sitruklaq/Mini-Pneumatics/README.md

# Mini-Pneumatics

A repository for the mini-pneumatic system for soft robotics.



The device has positive, negative, and exhaust inputs that control 1 output channel.

Pressure is monitored through a pressure sensor.
