sitruklaq/Mini-Pneumatics/Images/Layout.md

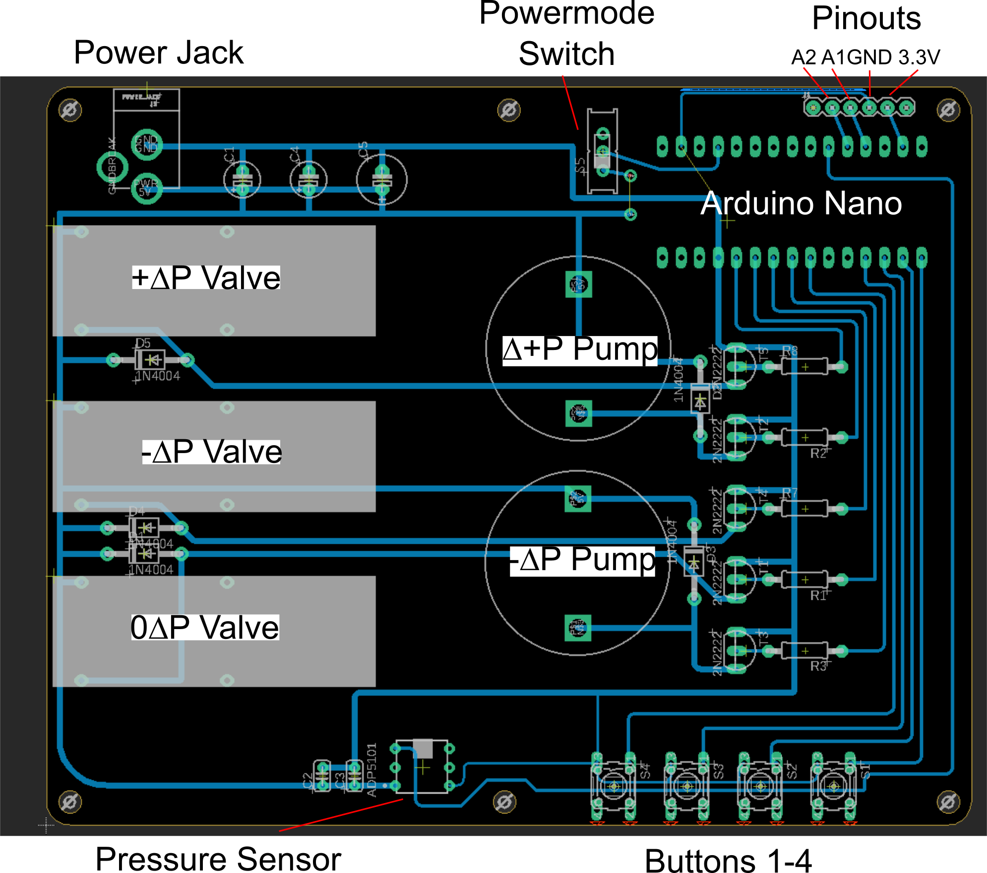
[picture p1: Images/layout.png]
layout


# Arduino Pin Assignments

| Item | Pin  | Valve/Pump Number |
| --- | ---- | --- |
| ∆+P Valve | 2 | 0 |
| -∆P Valve | 4 | 1 |
| 0∆P Valve | 5 | 2 |
| +∆P Pump | 3 | |
| -∆P Pump | 6 | |
| Button 1 | 9 | |
| Button 2 | 10 | |
| Button 3 | 11 | |
| Button 4 | 12 | |
| Pressure Sensor | A2 | |
