sitruklaq/Mini-Pneumatics/Components/BOM small pneumatics.xlsx

Small Pneumatics BOM
 |  | Description | Quantity | Pack Cost | Pack Amount | Unit Cost | Total Cost | Part Number` | Supplier | Purchase Link
 | Power Generation
 |  | Barrel Jack 2.1mm DC | 1 |  |  | $0.65 | $0.65 |  | creatroninc | https://www.creatroninc.com/product/1mm-dc-barrel-jack/?search_query=barrel+jack&results=22
 |  | Switch | 1
 | Electrical Control | Arduino Nano | 1 | $19.99 | 3 | $6.66 | $6.66 | Arduino 2560 | amazon.ca | https://www.amazon.ca/Elegoo-Board-ATmega2560-ATMEGA16U2-Arduino/dp/B01H4ZDYCE?s=hi
 | Pneumatics | Pneumatic Pumps Vacuum Pump 12V Mini Diaphragm Air Compressor with Silicone Tube | 2 | 6.99 | 1 | 6.99 | $13.98 |  | amazon.ca | https://www.amazon.ca/gp/product/B07C7341PP/ref=ppx_yo_dt_b_search_asin_title?ie=UTF8&psc=1
 |  | Pneumatic Valves | 3 |  |  | $6.95USD EA (min 25) | 76.45 |  | Jameco | https://www.jameco.com/z/RLB204KP30B-Asco-Valve-and-Instrument-2-Way-Barbed-Solenoid-Air-Valve-Normally-Closed_2258401.html
 |  | diode 1N4001 50V 1A rectifier Diode | 5 |  |  | 0.105 (0.42 per 4) | $1.16 | DIREC-004001 | creatroninc | https://www.creatroninc.com/product/1n4001-50v-1a-rectifier-diode-4-pack/?search_query=diode&results=75
 |  | transistor SS8050 - NPN BJT (25V 1.5A) | 5 |  |  | 0.6 | $6.60 | TRANQ-008050 | creatroninc | https://www.creatroninc.com/product/ss8050-npn-bjt-25v-15a/?search_query=transistor&results=146
 |  | resistor | 5 |  |  | ~0 | $0.00 |  | find a resistor pack around
 | sensor bank | pressure sensor Panasonic +-100kPa DIP mount | 1 |  |  | 60 | $60.00 | 769-ADP5101 | mouser.ca | https://www.mouser.ca/ProductDetail/Panasonic/ADP5101
 |  | capacitors
 | IO | Tactile Switches 0.05A 24VDC SPST Round Button | 4 |  |  | 0.68 | 2.72 | B3W-1020 | mouser.ca | https://www.mouser.com/ProductDetail/omron/b3w-1020/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
 | PCBS | dual or one sided PCB | 1 |  |  | 24 per 25 | $1.00 |  | bantamtools.com | https://www.bantamtools.com/miscellaneous/printed-circuit-board-blanks
 | Assorted | tubing
 |  | luer connectors
 |  | pin extenders
 |  | standoffs and screws 250Pcs M3 Male to Female Hex Column Standoff Spacer Pillars Screws Nuts Assortment Kit with Storage Box (M3) | 1 pack |  |  | 18.69 |  |  | amazon.ca | https://www.amazon.ca/250Pcs-Standoff-Pillars-Assortment-Storage/dp/B071RXSMW6?s=gateway
