sitruklaq/Mini-Pneumatics/PCB/mini system- 5 components.brd

## EAGLE design PCB/mini system- 5 components.brd (2020-03-27)

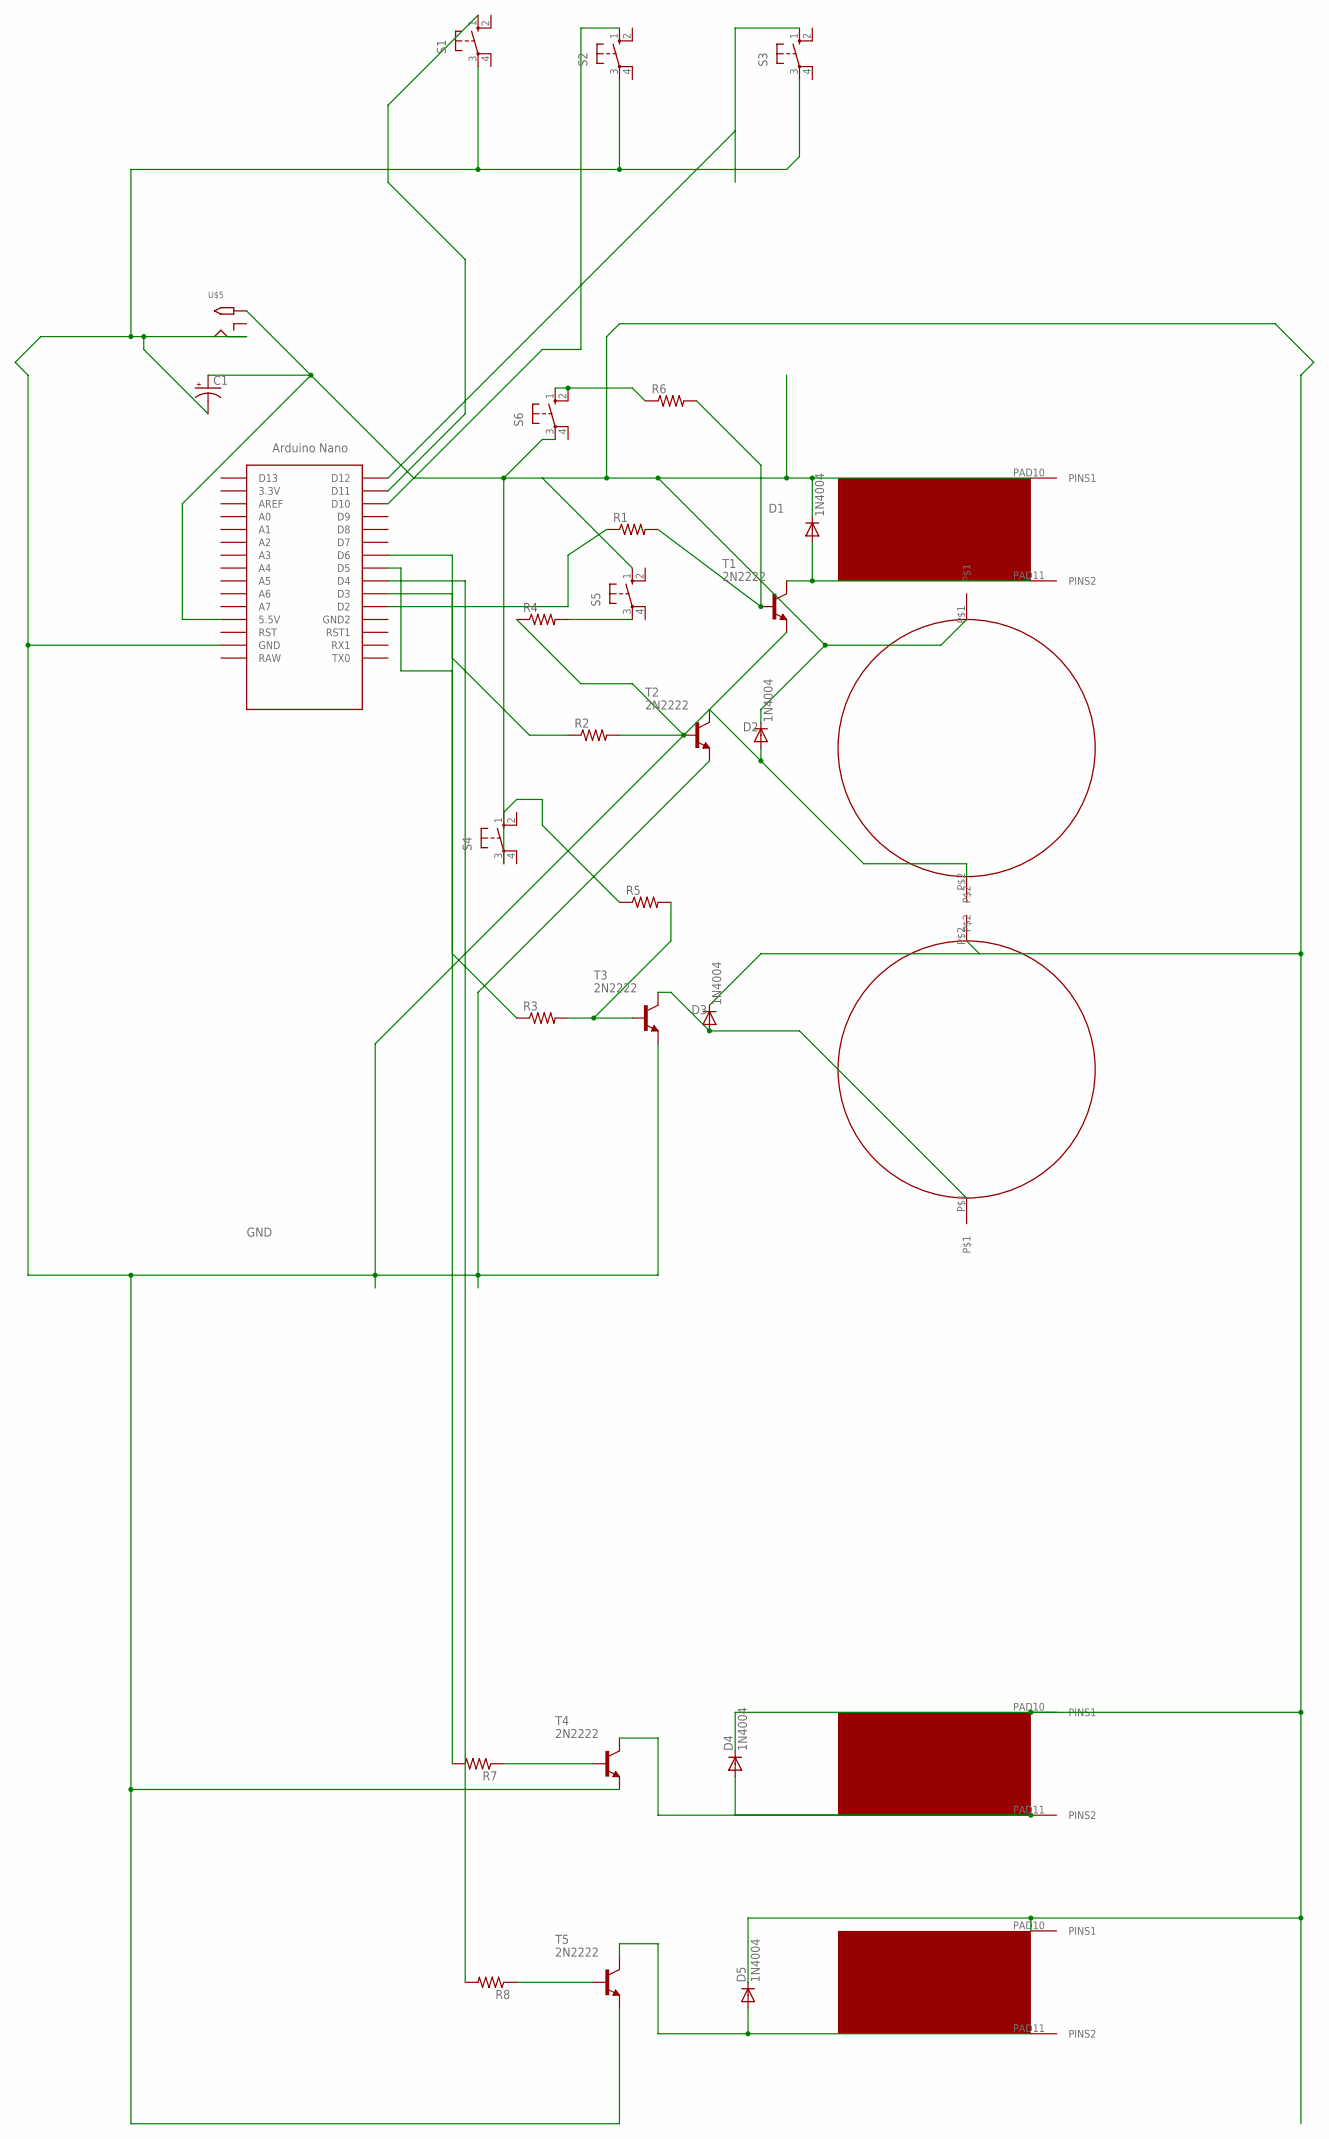
[picture p2: schematic mini system- 5 components.sch]

Parts:
C1: CPOL-USE2.5-5; E2,5-5
D1, D2, D3, D4, D5: 1N4004; DO41-10
PUMP1: DCPUMP; PUMP
R1, R2, R3, R4, R5, R6, R7, R8: R-US_0207/10; 0207/10
S1, S2, S3, S4, S5, S6: 10-XX; B3F-10XX
T1, T2, T3, T4, T5: 2N2222; TO92-EBC-OVAL
U$1: NANO
U$2, U$3, U$6: VALVE; VALVTEST2
U$4: DCPUMP; PUMP
U$5: 2.1MMJACKTHM; PJ-102A

Connections:
5V: C1.+, D1.C, D2.C, D3.C, D4.C, D5.C, PUMP1.P$1, S4.3, S5.1 (S), S6.3, U$1.5V (5.5V), U$2.PAD10 (PINS1), U$3.PAD10 (PINS1), U$4.P$2, U$5.TIP, U$6.PAD10 (PINS1)
GND: C1.-, S1.3, S2.3, S3.3, T1.E, T2.E, T3.E, T4.E, T5.E, U$1.GND, U$5.RING
unnamed: R1.2, R6.2, T1.B
unnamed: R2.2, R4.1, T2.B
unnamed: R3.2, R5.2, T3.B
unnamed: R1.1, U$1.D2
unnamed: D2.A, PUMP1.P$2, T2.C
unnamed: R3.1, U$1.D5
unnamed: R2.1, U$1.D6
unnamed: D1.A, T1.C, U$2.PAD11 (PINS2)
unnamed: D3.A, T3.C, U$4.P$1
unnamed: R4.2, S5.3
unnamed: S1.1 (S), U$1.D11
unnamed: S2.1 (S), U$1.D10
unnamed: S3.1 (S), U$1.D12
unnamed: R6.1, S6.1 (S), S6.2 (S1)
unnamed: R5.1, S4.1 (S)
unnamed: D4.A, T4.C, U$3.PAD11 (PINS2)
unnamed: R7.1, T4.B
unnamed: R7.2, U$1.D3
unnamed: R8.2, U$1.D4
unnamed: R8.1, T5.B
unnamed: D5.A, T5.C, U$6.PAD11 (PINS2)

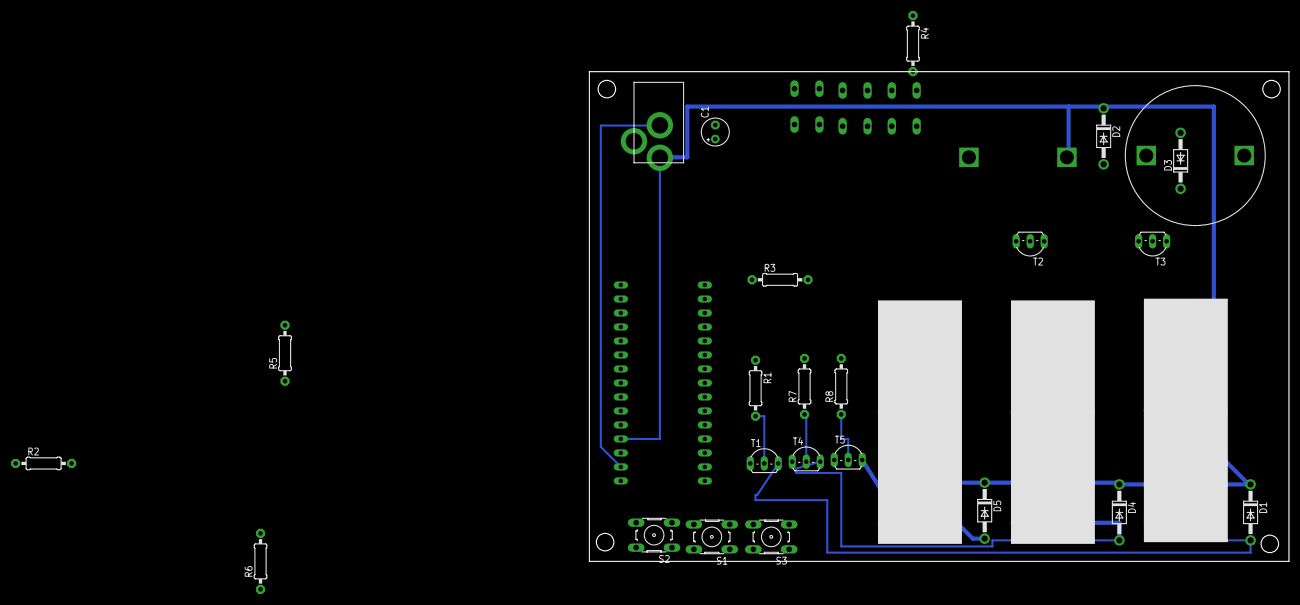
[picture p3: board mini system- 5 components.brd from above]

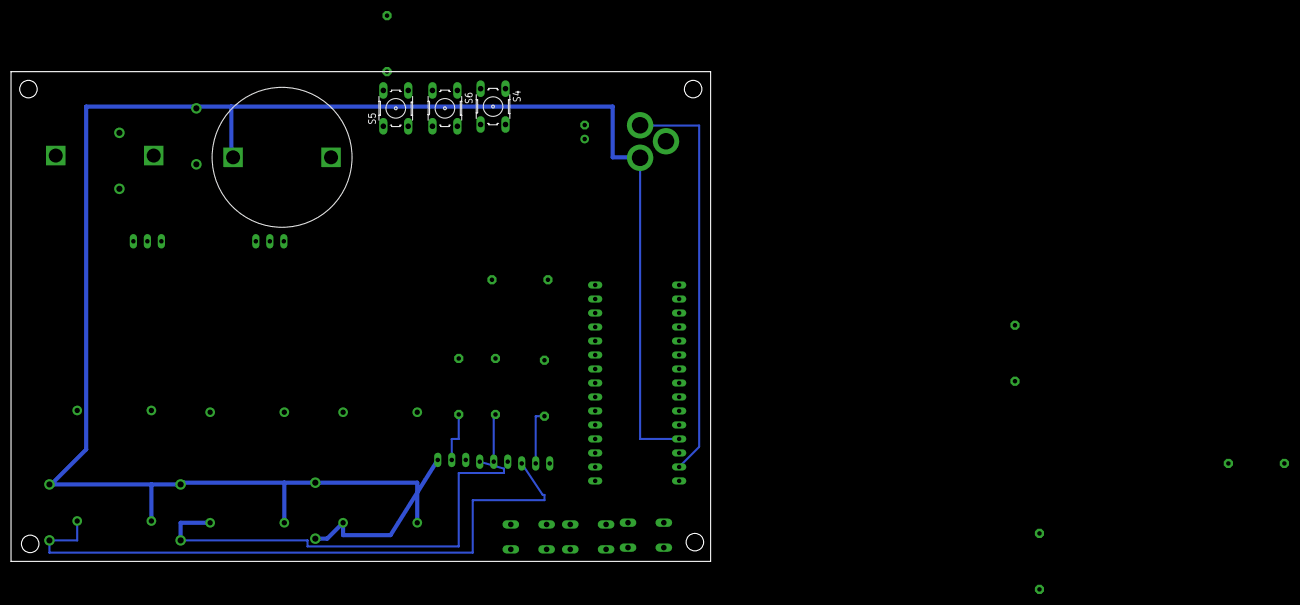
[picture p4: board mini system- 5 components.brd from below]

Board: 2 copper layers, 127.0 x 88.9 mm, 32 parts (4 on the bottom side), 23 nets.
