sitruklaq/Mini-Pneumatics/PCB/mini system- 5 components vertical moved nano.brd

## EAGLE design PCB/mini system- 5 components vertical moved nano.brd (2020-03-27)

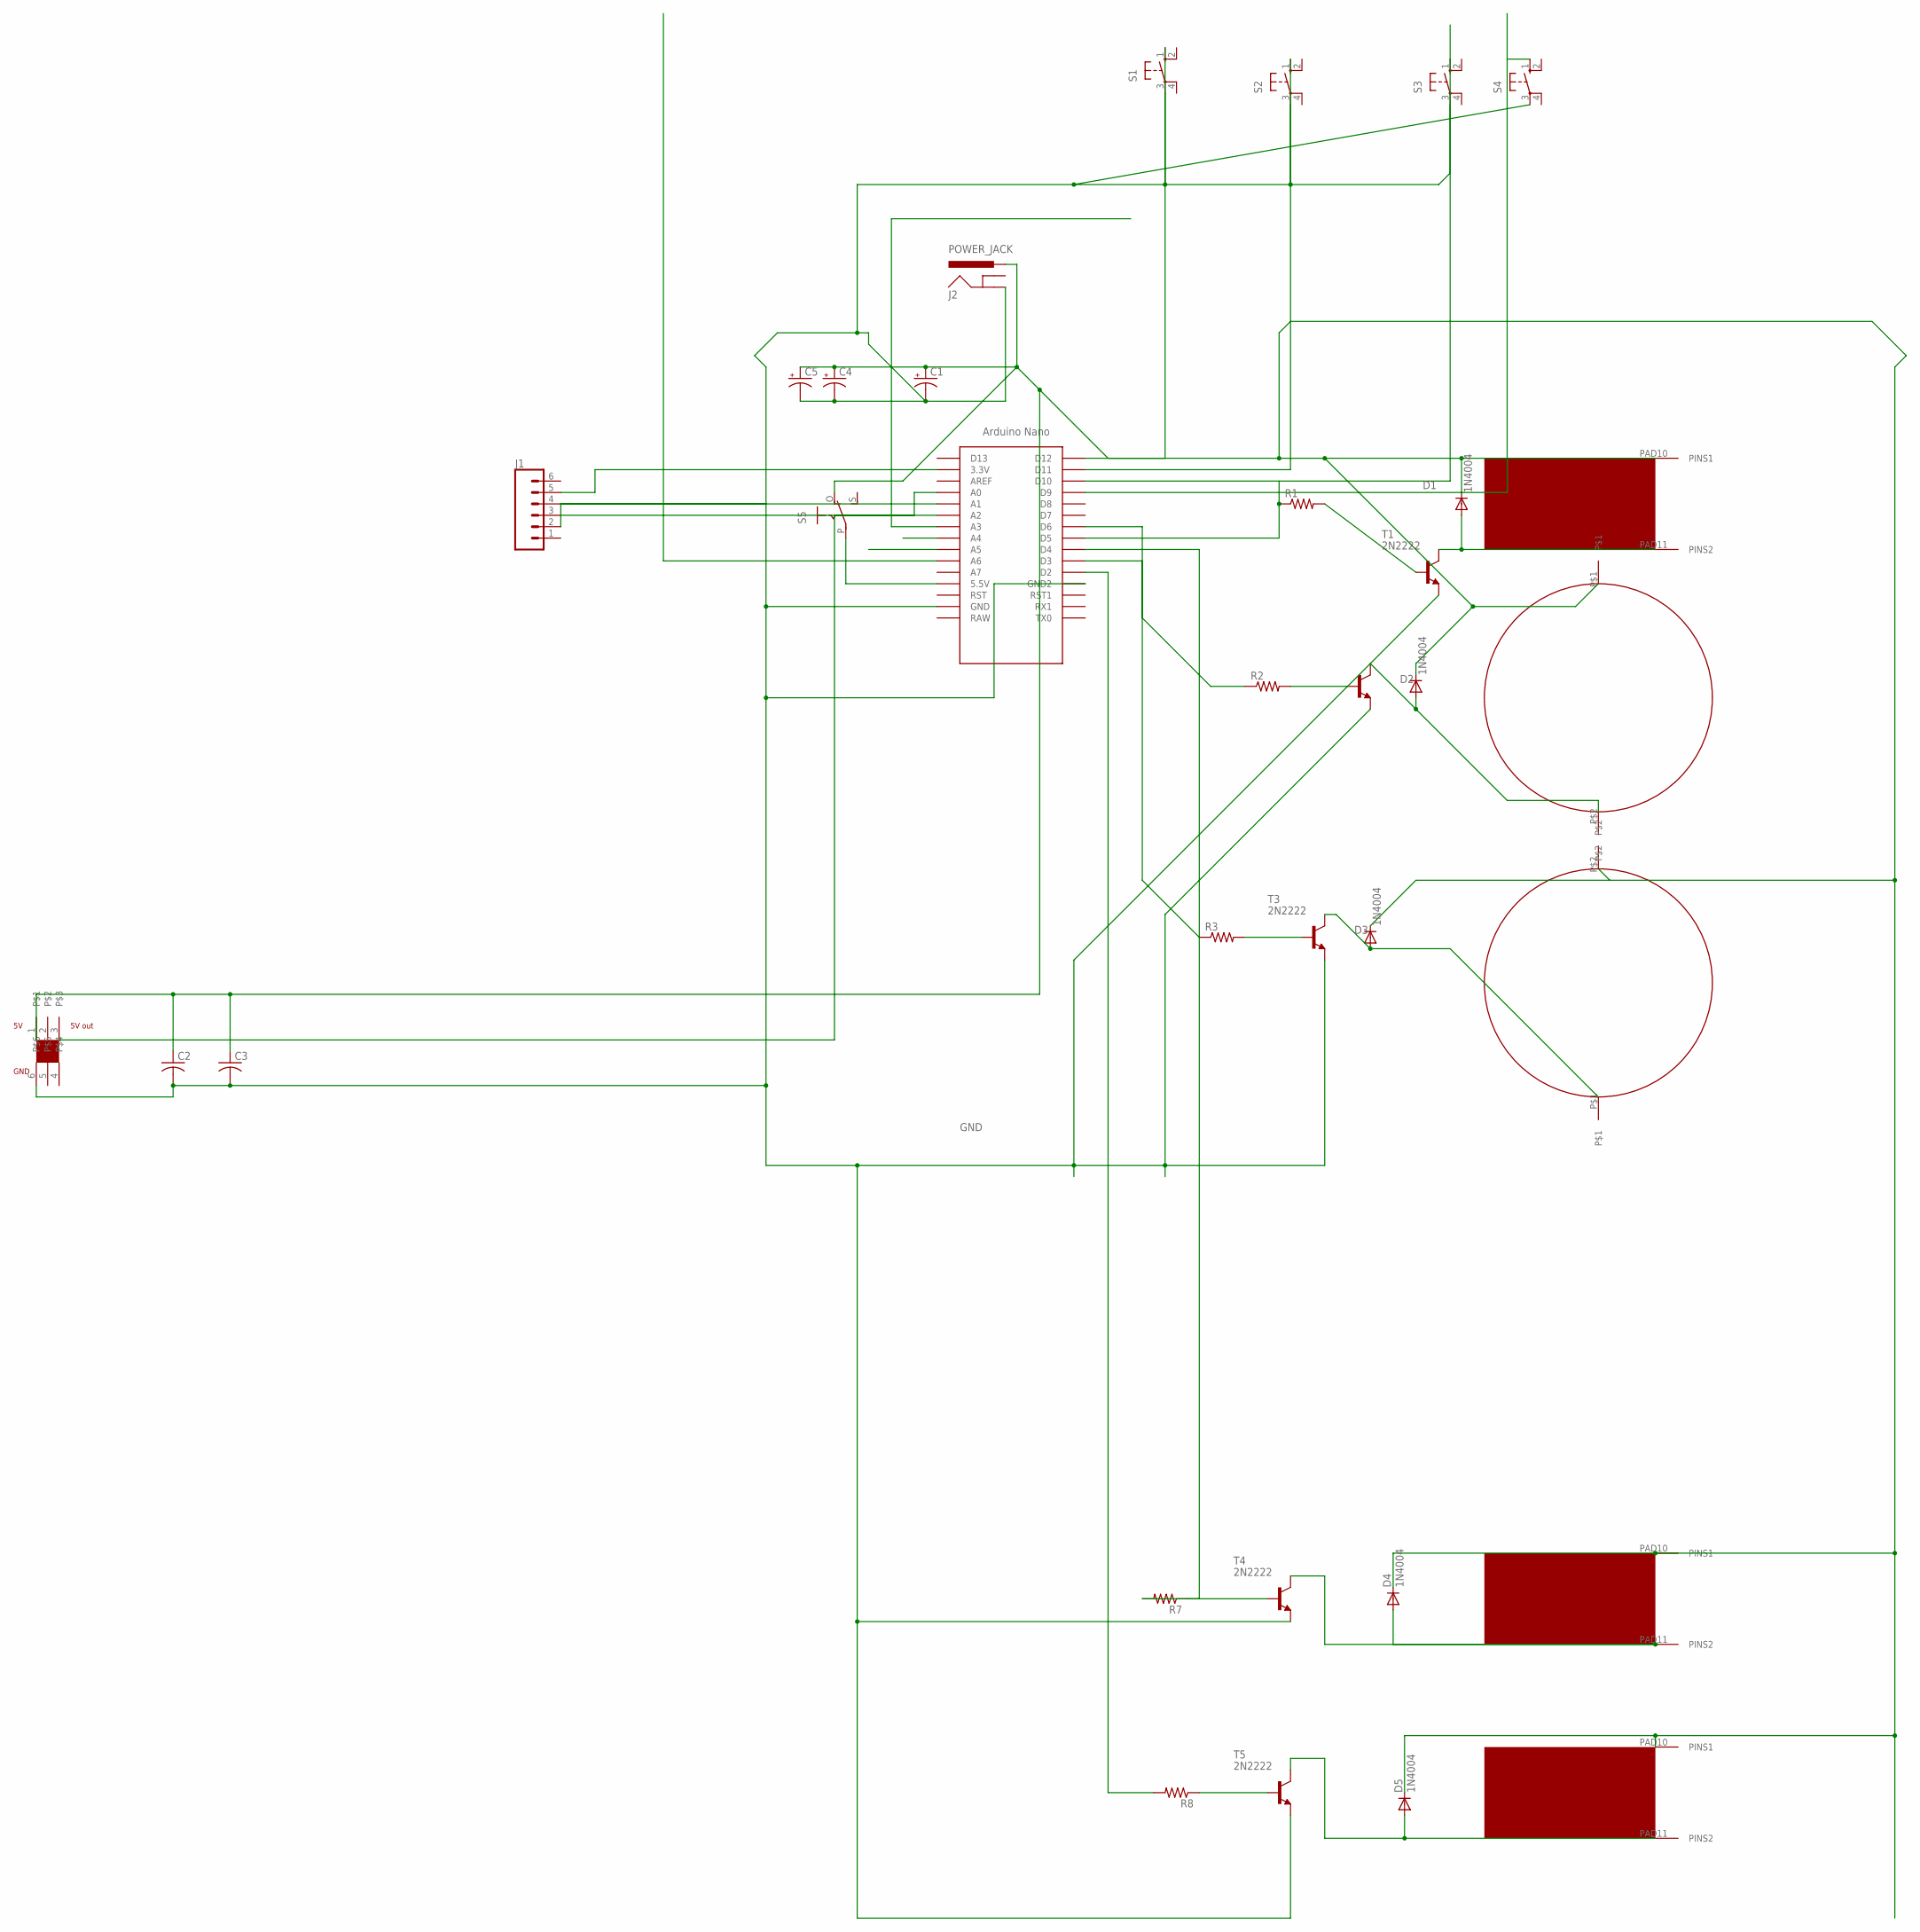
[picture p5: schematic mini system- 5 components vertical moved nano.sch]

Parts:
C1, C4: CPOL-USE2.5-5; E2,5-5
C2, C3: C-US025-024X044; C025-024X044
C5: CPOL-USE2.5-7; E2,5-7
D1, D2, D3, D4, D5: 1N4004; DO41-10
J1: CONN_06SILK_FEMALE_PTH; 1X06
J2: POWER_JACK; POWER_JACK_PTH
PUMP1: DCPUMP; PUMP
R1, R2, R3, R7, R8: R-US_0207/10; 0207/10
S1, S2, S3, S4: 10-XX; B3F-10XX
S5: EG1218S; EG1218
T1, T2, T3, T4, T5: 2N2222; TO92-EBC-OVAL
U$1: NANO
U$2, U$3, U$6: VALVE; VALVTEST2
U$4: DCPUMP; PUMP
U$7: ADP5101; DIP750W53P254L720H850Q6B

Connections:
5V: C1.+, C2.1, C3.1, C4.+, C5.+, D1.C, D2.C, D3.C, D4.C, D5.C, J2.PWR, PUMP1.P$1, S5.O, U$2.PAD10 (PINS1), U$3.PAD10 (PINS1), U$4.P$2, U$6.PAD10 (PINS1), U$7.1
GND: C1.-, C2.2, C3.2, C4.-, C5.-, J1.4, J2.GND, S1.3, S2.3, S3.3, S4.3, T1.E, T2.E, T3.E, T4.E, T5.E, U$1.GND, U$1.GND1 (GND2), U$7.6
unnamed: R1.2, T1.B
unnamed: R2.2, T2.B
unnamed: R3.2, T3.B
unnamed: R1.1, U$1.D5
unnamed: D2.A, PUMP1.P$2, T2.C
unnamed: R3.1, U$1.D6
unnamed: R2.1, U$1.D3
unnamed: D1.A, T1.C, U$2.PAD11 (PINS2)
unnamed: D3.A, T3.C, U$4.P$1
unnamed: R8.2, U$1.D2
unnamed: J1.5, U$1.3.3V
unnamed: J1.3, U$1.A0
unnamed: S5.P, U$1.5V (5.5V)
unnamed: J1.2, U$1.A1
unnamed: D4.A, T4.C, U$3.PAD11 (PINS2)
unnamed: R7.1, T4.B
unnamed: R7.2, U$1.D4
unnamed: R8.1, T5.B
unnamed: D5.A, T5.C, U$6.PAD11 (PINS2)
unnamed: U$1.A2, U$7.3
unnamed: S3.1 (S), U$1.D10
unnamed: S4.1 (S), U$1.D9
unnamed: S2.1 (S), U$1.D11
unnamed: S1.1 (S), U$1.D12

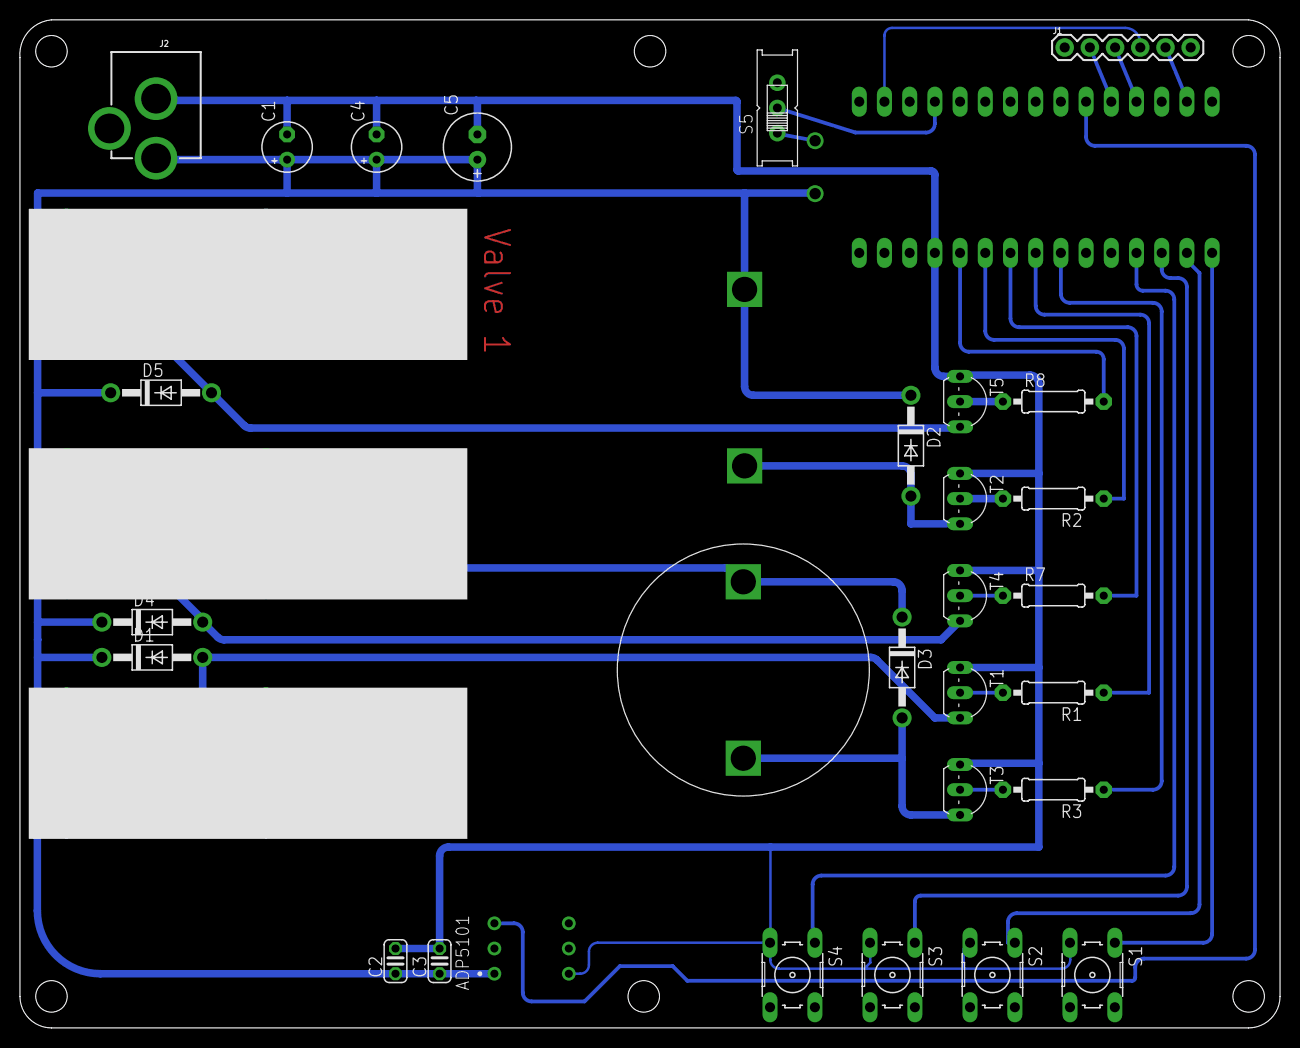
[picture p6: board mini system- 5 components vertical moved nano.brd from above]

Board: 2 copper layers, 127.0 x 101.6 mm, 34 parts (1 on the bottom side), 26 nets.
